raviumadi/Embedded_Ultrasonics/README.md

# Embedded Ultrasonics 

##  Open Source Microcontroller-Based Systems for Studying Echolocating Bats and Other Vocally Active Animals

## **Associated Peer-reviewed Publications**

Umadi, Ravi. ‘BATSY4-PRO: An Open-Source Multichannel Ultrasound Recorder for Field Bioacoustics’. *BMC Ecology and Evolution*, September 2026. https://doi.org/10.1186/s12862-026-02592-y.

Umadi, Ravi. ‘ESPERDYNE: A Dual-Band Heterodyne Monitor and Ultrasound Recorder for Bioacoustic Field Surveys’. *Methods in Ecology and Evolution* 17, no. 3 (2026): 768–77. https://doi.org/10.1111/2041-210x.70241.

## Overview

This repository contains firmware and supporting material for a family of
open-source ultrasonic recording and monitoring systems, including the system
described in:

Currently, it includes the following complementary systems:  

1. **Batsy4-Pro** – a Teensy 4.1–based multichannel ultrasonic recorder designed for high-fidelity capture of echolocation calls at up to 192 kHz.  
2. **Espertillio** – a heterodyning, recording & playback unit using an ESP32, capable of live monitoring, bat call playback, and SD card recording.  (Under further development)
3. **Esperdyne** - A pocketable, real-time heterodyne bat-call listener and “tap-to-save” field recorder built on ESP32-S3.

Together, these systems allow researchers to perform **field experiments** involving localisation, call analysis, and behavioural playback under natural foraging conditions.

More projects will be added as the systems are developed and tested. Check back again.

**See [Bat Reviewer](https://github.com/raviumadi/Bat-Reviewer.git) for a software tool for validating and sorting of field recordings from any of these devices, and to hear bat calls with heterodyne demodulation on the computer.**

<p align="center">
Batsy4-Pro multichannel ultrasonic recorder
  
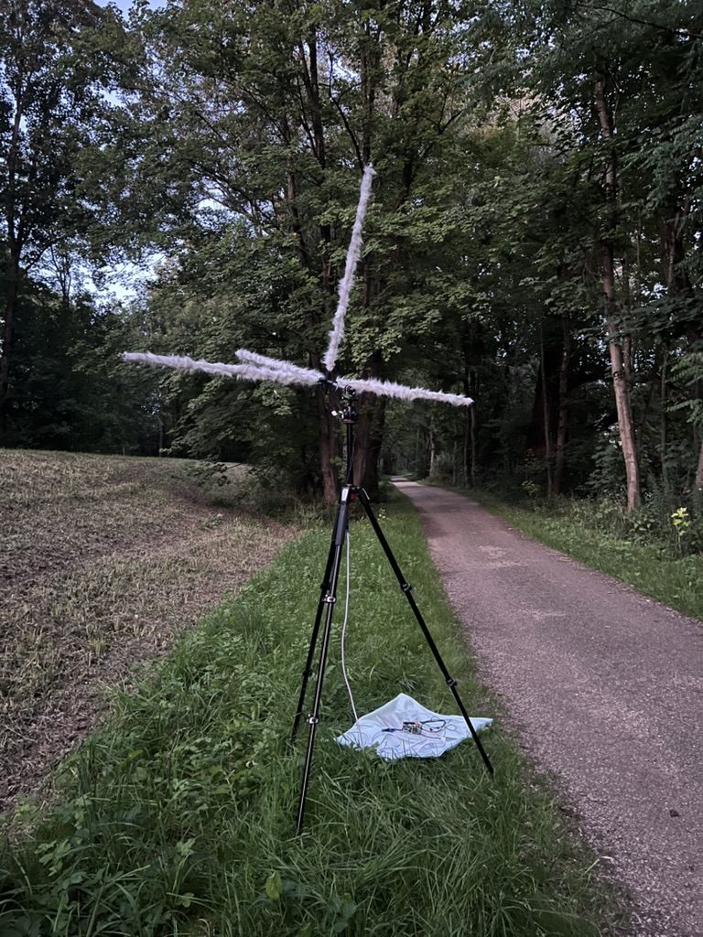
[picture p2: img/Field_Array.jpeg]
ESP32_HRP Device
  
</p>

---

## Features

### Batsy4-Pro 

- Current firmware: **version 1.1.0**.
- Records **4 ultrasonic channels** at 192 kHz - extendable up to 8 analogue channels.
- Uses a **5-second PSRAM ring buffer** for retrospective capture.
- Automatically indexes WAV filenames from the SD card at startup.
- Provides **tunable heterodyne monitoring** from 10–85 kHz and a direct **PT passthrough mode** for audible-frequency monitoring without frequency conversion.
- Monitoring input is selectable from Channels 1–4 or **MX**, which sums all four inputs, without altering the four-channel recording.
- Uses a redesigned 128 x 64 OLED interface with highlighted **CARRIER**, **CH**, and **VOLUME** controls selected sequentially using the rotary pushbutton.
- Displays `PT` and `MX` when selected, the next recording number, the active filename during recording and saving, and the firmware version on the startup splash screen.
- Designed for synchronised microphone array recordings.
- *[OSHW] DE000165 | Certified open source hardware | oshwa.org](https://certification.oshwa.org/de000165.html)*

### Espertillio

- **Heterodyne* real-time playback** for live bat monitoring.
- **FM/CF synthetic call playback** for behavioural tests.
- Records ultrasonic input to SD card as WAV files.
- Switchable between FM and CF playback modes via a physical toggle.
- Supports Doppler-shift simulation for moving targets with synthesised CF calls. (Experimental feature for future development)
- Currently developed for a single channel use - if that's all you need. This version is much cheaper than Teensy-based hardware. 

### **ESPERDYNE**

ESPERDYNE is a **dual-channel heterodyne bat detector and recorder** built on the ESP32-S3 with onboard PSRAM and SD storage. It enables **real-time listening and immediate capture** of ultrasonic signals in the field with an intuitive, low-power design.

- Live **dual-channel heterodyne monitoring** at **192 kHz sample rate**
- Independent **tunable carrier frequency** per channel via rotary encoder (10–85 kHz range, 5 kHz steps)
- **Stereo / Mix mode** toggle for flexible playback (true stereo or averaged mono)
- **Tap-to-save recording** from a **5-second PSRAM ring buffer** to WAV on SD card (REC###.WAV)
- **OLED UI (128×32)** displays carrier frequencies, volume, file index, and mode
- **Rotary encoder** with push-switch to toggle between frequency and volume adjustment
- **Dedicated buttons** for record, OLED toggle, channel 2 edit, and mix mode toggle
- **Auto file indexing** on boot (no overwrite of existing recordings)
- [OSHW] | DE000166 | Certified open source hardware |  [oshwa.org](https://certification.oshwa.org/de000166.html)

This version supersedes the earlier proof-of-concept, integrating full **UI controls**, **PSRAM-backed ring buffer recording**, and **independent heterodyne channels** for scientific and educational use.

### Remote Trigger

- Batsy4-Pro may be combined with an ESP-NOW-based remote trigger. This simple yet effective module frees hands during field recordings. The system may be set up and monitored from a distance, and recordings may be remotely triggered. 
- You will need two ESP32 dev kits -- sender and receiver.
- I use an audio jack Bluetooth Plugin (e.g., [Avantree Relay](https://www.amazon.de/Avantree-Relay-Bluetooth-Headphones-Transmitter-black/dp/B0C3QQ4X6F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)) to hear the heterodyned audio over Bluetooth headphones. This allows me to not be close to the setup and still be able to perform recordings. The BT addition has a perceptible delay, about 100ms or so, but immaterial for recording experiments.

---

## Hardware Requirements

### Batsy4-Pro

- Teensy 4.1 microcontroller.
- Multiple ultrasonic microphones (e.g., Knowles MEMS series).
- SD card (high-speed, Class 10 recommended).
- APS6404L-3SQR PSRAM - 8MB (or equivalent)
- PCM5102A or similar DAC
- WM8782 I2S ADC
- Toggle buttons, rotary encoders etc (See code and BOM)

### Espertillio/Esperdyne

- ESP32 development board with I2S microphone and DAC output (e.g., PCM5102A).
- SD card breakout module.
- Buttons for playback and record control, and a mode toggle switch.
- Speaker or amplifier for output.
- Use the same ADC and Mics as above.

---

## Installation & Usage

1. **Clone this repository**:

   ```bash
   git clone git@github.com:raviumadi/Embedded_Ultrasonics.git
   ```

2. **Open each `.ino` file** in Arduino IDE.

3. **Install dependencies**:

   - For Teensy: [Teensyduino](https://www.pjrc.com/teensy/td_download.html)
   - For ESP32: Install `esp32` board support via Arduino Board Manager.

4. **Compile and upload** the appropriate firmware to your device.

5. **Connect hardware** according to the pin definitions in each `.ino` file.

6. **Run field tests** as described in the manuscript.

---

## Data Format

- All recordings are saved as **16-bit PCM WAV**.
- Filenames are automatically generated in the format:  
  - `REC###.WAV` for ESP32 recordings.
  - `BAT###.WAV` for Batsy4-Pro recordings.
- Sampling rate: **192,000 Hz** (configurable in code).

---

## Related Resources

- [Teensy 4.1 Documentation](https://www.pjrc.com/store/teensy41.html)
- [i.MX RT1060 Processor Reference Manual R3](https://www.nxp.com/webapp/Download?colCode=IMXRT1060RM)
- [Teensy Audio Library](http://www.pjrc.com/teensy/td_libs_Audio.html)
- [WM8782 - 24-bit 192 kHz Stereo ADC Datasheet](https://statics.cirrus.com/pubs/proDatasheet/WM8782_v4.8.pdf) 
- [PCM510xA 2.1 VRMS, 112/106/100 dB Audio Stereo DAC with PLL and 32-bit, 384 kHz PCM Interface](https://www.ti.com/lit/ds/symlink/pcm5100a-q1.pdf?ts=1754321963376)
- [SPU0410LR5H-QB MEMS Microphones](https://mm.digikey.com/Volume0/opasdata/d220001/medias/docus/384/SPU0410LR5H-QB_RevH_3-27-13.pdf)
- [Inter-IC Sound (I2S) ESP32 Documentation](https://docs.espressif.com/projects/esp-idf/en/stable/esp32/api-reference/peripherals/i2s.html)
- [Arduino IDE](https://www.arduino.cc/en/software/)

## License

This documentation is licensed under the **Creative Commons Attribution–NonCommercial 4.0 International (CC BY-NC 4.0)**.  
See the `LICENSE` file for details.

---

## Disclaimer

The code in this repository is provided **"as is"**, without warranty of any kind.  
It is intended for **research and educational purposes only**.  
Use in environments involving wildlife should comply with local regulations and ethical guidelines.

## Commercial Development 

Please contact the author via https://biosonix.io if you are interested in developing commercial versions of the systems described here. 

<hr>
<h2>☕ Support my open science projects</h2>
<p>
This project is developed and maintained independently as part of my open research work.
If you find it useful and would like to support continued development, documentation,
and free public releases, consider buying me a coffee.
</p>
<p>
<a href="https://buymeacoffee.com/raviumadi"
   target="_blank"
   style="
     display: inline-block;
     padding: 10px 16px;
     background-color: #FFDD00;
     color: #000;
     font-weight: 600;
     border-radius: 6px;
     text-decoration: none;
     border: 1px solid #e6c800;
   ">
  ☕ Buy me a coffee
</a>
</p>

<p><em>All tools remain free for academic and research use.</em></p>
