raviumadi/Embedded_Ultrasonics/Batsy4-Pro/field_recordings/10April2025/note.md

- The date-time stamps on these recordings are default from the Teensy4.1 internal clock. The RTC keeper battery was installed afterwards.

- The recordings were made using a small 2D microphone array during the test phase. Which means you can't test these for localisation.
