raviumadi/Embedded_Ultrasonics/Batsy4-Pro/BOM.md

The following tables contain the Bill of Materials for the Batsy4-Pro and the field array used in the study.

## Batsy4-Pro

| Item | Description | Count | Unit Cost (Euro) | Source |
| :--- | :--- | --- | ---: | --- |
| Teensy 4.1 | Microcontroller | 1 | 39.50 | [reichelt.de](https://www.reichelt.de/de/de/shop/produkt/teensy_4_1_usb_ohne_header-283580) |
| WM8782 | I2S ADC | 2 | 14.90 | [Audio-phonics.fr](https://www.audiophonics.fr/en/devices-hifi-audio-adc/stereo-adc-board-wm8782-i2s-24bit-192khz-p-14897.html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) |
| PC5102A | I2S DAC | 1 | 7.99 | Amazon.de |
| MP1584EN | DC-DC 3A Power Step-Down Adjustable Module Buck Converter. Power supply module | 1 | 2 | Amazon.de |
| SSD1306 | OLED Display | 1 | 5.25 | [AZDelivery.de](https://www.az-delivery.de/en/products/0-96zolldisplay?variant=26462805705) |
| Push Buttons | User Input | 2 | 0.50 | Amazon.de |
| Rotary Encoder | User Input | 1 | 1.50 | Amazon.de |
| Circuit Switch | Power Supply ON/OFF | 1 | 0.25 | Amazon.de |
| Perforated PCB | System Base | 3 | 1.50 | Amazon.de |
| Hexnut Screws | PCB Stacking | Assorted | 5 | Amazon.de |
| Wiring | 18/22 gauge colored wires, | Assorted | 5 | Amazon.de |
| 6-Pin Connector | Mic power and signal connection | 1 | 14.99 | Amazon.de |
| CR2032 | RTC Battery | 1 | 1.50 | Generic |
| SPU0410LR5H-QB analogue MEMS microphones | Array Mics | 4 | 0.50 | Digikey.de |
| APS6404L-3SQR PSRAM - 8MB - SOP8 | External Memory | 2 | 2.50 | Tinytronics.nl |
| | | | **125.28 Eur** | |

## Field Array

The material list is only suggestive. Depending on your array design and local availability, choose whatever fits your construction idea.

| Item | Description | Count | Unit Cost (Euro) | Source |
| --- | --- | ----- | --- | --- |
| Aluminium Square Hollow Profiles 1 sqcm | Arms of the array | 4 | 4.99 | Hagebaumarkt |
| Aluminium Square Solid Profile 1 qcm | Holder, mounting rod | 1 | 7.99 | Hagebaumarkt |
| Ball Joint | Mounting on Tripod. Alternatively, attach directly to a 1/4" screw mount | 1 | 12-15 | Generic |
| 1/4" Tripod mount Hot show adapter | Between the holder and the ball joint | 1 | 5.99 | Amazon, generic brand |
| 6-way Plastic connector | holds the array arms and mounting rod | | 4.99 | Hagebaumarkt |
| Polyester fur | acoustis insulation, echo suppression from array arms | 1 sqm | 8.99 | Amazon, generic brand |
| Cables and Miscellaneous. | Extension cable, adhesives etc | NA | 20 | Local purchases |
| | | | **81.42** | |
