raviumadi/Embedded_Ultrasonics/Batsy4-Pro/firmware/BUILD_INFO.md

Firmware: Batsy4-Pro
Version: 1.1.0
Board: Teensy 4.1
Build tool: Arduino CLI 1.4.1
Teensy core: 1.61.0
Sampling rate: 192 kHz (custom PLL configuration)
Date: 2026-09-16
Status: Validated on Batsy4-Pro hardware
Monitoring: Channels 1–4 or MX; 10–85 kHz heterodyne or PT passthrough
