raviumadi/Embedded_Ultrasonics/img/batsy4-pro.png

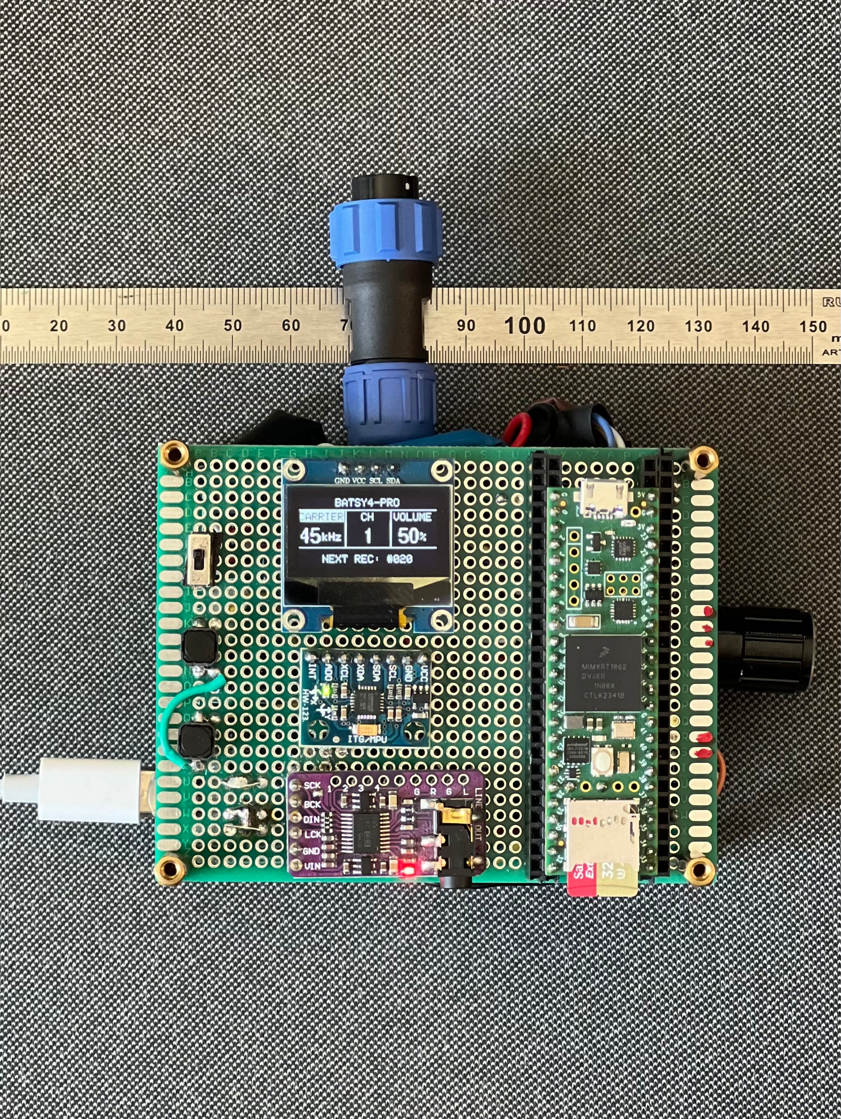
[picture p1: img/batsy4-pro.png]
img/batsy4-pro.png
